LucasEmanuel313/Lucas-Emanuel-PCEIoT/Altium Project/Entregaveis 1/Lucas Emanuel - PCEIoT.xlsx

Line # | Name | Description | Designator | Quantity | Manufacturer 1 | Manufacturer Part Number 1 | Manufacturer Lifecycle 1 | Supplier 1 | Supplier Part Number 1 | Supplier Unit Price 1 | Supplier Subtotal 1
 | 19-217/R6C-AL1M2VY/3T | Chip LED, Red, 5 V, 25 mA, -40 to 85 degC, 2-Pin SMD (0603), RoHS, Tape and Reel | DS1 | 1 | Lumex | SML-LX0603IW-TR | Volume Production | Digikey | 67-1548-1-ND | 0.22 | 0.22
 | 22-28-4033 | KK 254 Breakaway Header Vertical 3 Circuits 0.38um Gold Selective Plating Mating Pin 6.09mm | P1 | 1 | Molex | 22-28-4033 | Volume Production | Digikey | WM50016-03-ND | 0.3 | 0.3
 | 640456-2 | Connector 250V AC/DC 5A 2P 1 Row PCB - Vertical Mounting Polyester White | J1 | 1 | TE Connectivity | 640456-2 | Volume Production | Digikey | A1921-ND | 0.15 | 0.15
 | 709670110 | Pcb Mounting, Nylon 6.6, 11Mm Rohs Compliant: Yes |Wurth Elektronik 709670110 | M1, M2, M7, M8 | 4 | Wurth Electronics | 709670110 | Unknown | Digikey | 732-10378-ND | 0.3 | 1.2
 | 970080354 | WA-SBRII Brass Spacer Stud Metric Thread int./int. | M3, M4, M9, M10 | 4 | Wurth Electronics | 970080354 | Unknown | Digikey | 732-12838-ND | 0.39 | 1.56
 | 5033981892 | Micro SD Card Connector, Pitch 1.1 mm, 8 Position, Height 1.4 mm, -25 to 85 degC, RoHS, Tape and Reel | SKT1 | 1 | Molex | 503398-1892 | Volume Production | Digikey | WM11190CT-ND | 2.62 | 2.62
 | 61300811821 | Btb Conn, Rcpt, 8Pos, 1Row, 2.54Mm Rohs Compliant: Yes |Wurth Elektronik 61300811821 | J6, J7, J8, J9 | 4 | Wurth Electronics | 61300811821 | Unknown | Digikey | 732-61300811821-ND | 0.38 | 1.52
 | 61302011821 | THT Vertical Socket Header WR-PHD, Pitch 2.54 mm, Single Row, 20 pins | J4, J5 | 2 | Wurth Electronics | 61302011821 | Unknown | Digikey | 732-61302011821-ND | 0.83 | 1.66
 | ASMT-YTB7-0AA02 | LED Tri-Color Blue/Green/Red 469nm/529nm/623nm Chip LED 6-Pin PLCC T/R | D1A, D1B, D1C | 3 | Broadcom Avago | ASMT-YTB7-0AA02 | Volume Production | Digikey | 516-3132-1-ND | 1.39 | 4.17
 | BLM21PG331SN1D | IND, Chip Ferrite Bead, 330 Ohm, +/- 25%, 1.5 A, -55 to 125 degC, 0805 (2012 Metric), Tape and Reel | L1, L2 | 2 | Murata | LQG15HS15NJ02D | Volume Production | Digikey | 490-2625-1-ND | 0.1 | 0.2
 | BQ29700DSER | Li-Ion/Li Polymer Advanced Single-Cell Battery Protector IC Family 6-WSON -40 to 85 | U9 | 1 | Texas Instruments | BQ29700DSER | Volume Production | Digikey | 296-43985-1-ND | 0.49 | 0.49
 | C0603C101K5GACTU | Multilayer Ceramic Capacitor, 100 pF, 50 V, ï¿½ 10%, C0G (NP0), 0603 [1608 Metric] | C7 | 1 | KEMET | C0603C101K5GACTU | Volume Production | Digikey | 399-C0603C101K5GACTUCT-ND | 0.1 | 0.1
 | Capacitor 4.7µF +/-20% 10V 0603 | Chip Capacitor, 4.7µF +/-20%, 10V, 0603, Thickness 1 mm | C19, C20 | 2 | Yageo | CC0603KRX5R6BB475 | Volume Production | Digikey | 311-1455-1-ND | 0.21 | 0.42
 | CMEJ-0415-42-LP | 4.0 mm, Omnidirectional, PCB Mount, 2.0 Vdc, Elecret Condenser Microphone | MK1 | 1 | Same Sky | CMEJ-0415-42-LP | Volume Production | Digikey | 102-6541-ND | 0.39 | 0.39
 | CRCW06032K20FKEA | SMD Chip Resistor, 2.2 kOhm, ± 1%, 100 mW, 0603 [1608 Metric], Thick Film, General Purpose | R19, R36 | 2 | Vishay | CRCW06032K20FKEA | Volume Production | Digikey | 541-2.20KHDKR-ND | 0.1 | 0.2
 | CRCW0603150RFKEA | SMD Chip Resistor, 150 Ohm, ± 1%, 100 mW, 0603 [1608 Metric], Thick Film, General Purpose | R32A, R32B, R32C | 3 | Vishay | CRCW0603150RFKEA | Volume Production | Digikey | 541-150HCT-ND | 0.1 | 0.3
 | CRCW0603470RJNEA | Res Thick Film 0603 470 Ohm 5% 0.1W(1/10W) ±200ppm/°C Pad SMD Automotive T/R | R37 | 1 | Vishay | CRCW0603470RJNEA | Volume Production | Digikey | 541-470GCT-ND | 0.1 | 0.1
 | ERJ-3EKF2001V | SMD Chip Resistor, 2 kOhm, ï¿½ 1%, 100 mW, 0603 [1608 Metric], Thick Film, Precision | R38 | 1 | Panasonic | ERJ-3EKF2001V | Volume Production | Digikey | P2.00KHCT-ND | 0.1 | 0.1
 | ERJ-3EKF3300V | SMD Chip Resistor, 330 Ohm, ± 1%, 100 mW, 0603 [1608 Metric], Thick Film, Precision | R35 | 1 | Panasonic | ERJ-3EKF3300V | Volume Production | Digikey | P330HCT-ND | 0.1 | 0.1
 | FSM4JSMA | Switch Tactile OFF (ON) SPST Round Button Gull Wing 0.05A 12VDC 1.57N SMD Loose Piece | SW1, SW2, SW3 | 3 | TE Connectivity | FSM4JSMA | Volume Production | Digikey | 450-1129-ND | 0.26 | 0.78
 | GRM188R60J106ME47D | Multilayer Ceramic Capacitor, 10 uF, 6.3 V, ± 20%, X5R, 0603 [1608 Metric] | C8 | 1 | Murata | GRM188R60J106ME47D | Volume Production | Digikey | 490-3896-6-ND | 0.11 | 0.11
 | LM4040DYM3-2.5-TR | LM4040 Series 2.5 V ±1 % Precision Micropower Shunt Voltage Reference - SOT-23 | U8 | 1 | Microchip | LM4040DYM3-2.5-TR | Volume Production | Digikey | 576-1047-1-ND | 0.36 | 0.36
 | MAX4466EXK-T | Audio Amp Microphone 1-CH Mono Class-AB 5-Pin SC-70 T/R | U4 | 1 | Maxim | MAX4466EXK-T | Volume Production | Digikey | MAX4466EXK+CT-ND | 1.62 | 1.62
 | MCP73831T-2ACI/OT | MCP73831 Series Single-Cell Li-Ion/Li-Polymer Battery Charge Controller SOT-23-5 | U10 | 1 | Microchip | MCP73831T-2ACI/OT | Volume Production | Digikey | MCP73831T-2ACI/OTDKR-ND | 0.76 | 0.76
 | MPMS 003 0005 PH | Mach Screw Pan Head Phillips M3 | M5, M6, M11, M12 | 4 | Building Fasteners | MPMS 003 0005 PH | Unknown | Digikey | H742-ND | 0.1156 | 11.56
 | MS563702BA03-50 | Pressure Sensor, Barometric, 300 mbar, 1200 mbar, QFN, 8, -40 C | U5 | 1 | TE Connectivity | MS563702BA03-50 | Volume Production | Digikey | 223-1199-1-ND | 3.69 | 3.69
 | NTRV4101PT1G | NTRV4101PT1G P-channel MOSFET Transistor; 1.7 A; 20 V; 3-Pin SOT-23 | Q1, Q2, Q3 | 3 | ON Semiconductor | NTRV4101PT1G | Volume Production | Digikey | 488-NTRV4101PT1GCT-ND | 0.67 | 2.01
 | Resistor 0R +/- 5% 0603 100 mW | Chip Resistor, 0 Ohm, 0.1 W, -55 to 155 degC, 0603 (1608 Metric) | R4, R7, R12, R30, R31 | 5 | Yageo | RC0603JR-070RL | Volume Production | Digikey | 311-0.0GRDKR-ND | 0.01 | 0.1
 | Resistor 1k +/-1% 0603 100 mW | Chip Resistor, 1 KOhm, +/-1%, 0.1 W, -55 to 155 degC, 0603 (1608 Metric) | R6, R11, R14, R17 | 4 | Yageo | RC0603FR-071KL | Volume Production | Digikey | 311-1.00KHRDKR-ND | 0.009 | 0.09
 | Resistor 10k +/-1% 0603 100 mW | Chip Resistor, 10 KOhm, +/- 1%, 01 W, -55 to 155 degC, 0603 (1608 Metric) | R1, R2, R3, R9, R10, R20, R21, R22, R23, R24, R25, R28, R29, R39, R40, R41, R42 | 17 | Yageo | RC0603FR-1310KL | Volume Production | Digikey | 13-RC0603FR-1310KLCT-ND | 0.009 | 0.153
 | Resistor 100k +/-1% 0603 100 mW | Chip Resistor, 100 KOhm, +/- 1%, 0.1 W, -55 to 155 degC, 0603 (1608 Metric) | R15, R16 | 2 | Yageo | RC0603FR-13100KL | Volume Production | Digikey | 13-RC0603FR-13100KLCT-ND | 0.009 | 0.09
 | SC0918 | Raspberry Pi Pico W RP2040 | U1 | 1 | Raspberry Pi | SC0918 | Volume Production | Digikey | 2648-SC0918CT-ND | 6 | 6
 | SHT40I-AD1B-R3 | Humidity And Temperature Sensor | U6 | 1 | Sensirion | SHT40I-AD1B-R3 | Unknown | Digikey | 1649-SHT40I-AD1B-R3CT-ND | 2.21 | 2.21
 | SX1509BIULTRT | IC Gpio Expander I2C 16CH 28QFN / I2C Interface 5.5V 28-PIN Qfn-ut Ep T/r | U7 | 1 | Semtech | SX1509BIULTRT | Volume Production | Digikey | SX1509BIULCT-ND | 4.79 | 4.79
 | TC33X-2-104E | Cermet trimmer potentiometer, 100 kΩ, 0.1 W, SMD, on top, TC33X-2-104E | R18 | 1 | Bourns | TC33X-2-104E | Volume Production | Digikey | TC33X-104ECT-ND | 0.25 | 0.25
 | VJ0603Y103KXAAC | Multilayer Ceramic Capacitor, 0.01 uF, 50 V, ± 10%, X7R, 0603 [1608 Metric] | C15, C16, C17, C27 | 4 | Vishay Vitramon | VJ0603Y103KXAAC | Volume Production | Digikey | 720-1376-1-ND | 0.19 | 0.76
 | VJ0603Y104MXJCW1BC | Multilayer Ceramic Capacitor, 0.1 uF, 16 V, ± 20%, X7R, 0603 [1608 Metric] | C1, C2, C3, C4, C5, C6, C9, C10, C11, C12, C13, C14, C18, C21, C22, C23, C24, C25, C26, C28, C29 | 21 | Vishay Vitramon | VJ0603Y104MXJCW1BC | Volume Production | Digikey | 720-VJ0603Y104MXJCW1BCCT-ND | 0.058 | 1.22
 | ICM-42670-P | Mems Module, 1.71-3.6 V, Lga-14 Rohs Compliant: Yes |Tdk Invensense ICM-42670-P | U2 | 1 | TDK InvenSense | ICM-42670-P | Manual Solution | DigiKey | 1428-ICM-42670-PTR-ND | 3.66 | 3.66
 | CRCW060350R0FKEA | SMD Chip Resistor, 50 Ohm, ± 1%, 100 mW, 0603 [1608 Metric], Thick Film, General Purpose | R33A, R33B, R33C, R34A, R34B, R34C | 6 | Vishay Dale | CRCW060350R0FKEA | Volume Production | Mouser | 71-CRCW0603-50-E3 | 0.033 | 0.33
 | OPT4001DTSR | High-speed high-precision digital ambient light sensor (ALS) 8-SOT-5X3 -40 to 85 | U3 | 1 | Texas Instruments | OPT4001DTSR | Volume Production | Mouser | 595-OPT4001DTSR | 2.17 | 2.17
