LucasEmanuel313/Lucas-Emanuel-PCEIoT/(list of files, drawings)

Other design files:
Altium Project/Lucas Emanuel - PCEIoT/Lucas Emanuel - PCEIoT.PrjPcb
Altium Project/Lucas Emanuel - PCEIoT/PCB1.PcbDoc
Altium Project/Lucas Emanuel - PCEIoT/Sources/[1] TableOfContents.SchDoc
Altium Project/Lucas Emanuel - PCEIoT/Sources/[2] BlockDiagram.SchDoc
Altium Project/Lucas Emanuel - PCEIoT/Sources/[3] TopLevel.SchDoc
Altium Project/Lucas Emanuel - PCEIoT/Sources/[4] Sensors.SchDoc
Altium Project/Lucas Emanuel - PCEIoT/Sources/[5] ButtonsAndLeds.SchDoc
Altium Project/Lucas Emanuel - PCEIoT/Sources/[6] RgbLed.SchDoc
Altium Project/Lucas Emanuel - PCEIoT/Sources/[7] PowerManagement.SchDoc
Altium Project/Lucas Emanuel - PCEIoT/Sources/[8] Conectors.SchDoc
Altium Project/Lucas Emanuel - PCEIoT/Sources/[9] Mechanical.SchDoc
