LucasEmanuel313/Lucas-Emanuel-PCEIoT/(commit log)

2025-02-17 [Sheets] Primeiro commit, criação de sheets e estrutura geral do projeto
    [Lucas Emanuel - PCEIoT.PrjPcb, [1] TableOfContents.SchDoc, [2] BlockDiagram.SchDoc, [3] TopLevel.SchDoc, [4] Sensors.SchDoc, [5] ButtonsAndLeds.SchDoc, [6] RgbLed.SchDoc, [7] PowerManagement.SchDoc]
2025-02-17 [Sheets] Finalização das sheets table of Contents e BlockDiagram. Atualização do TopLevel.
    [Lucas Emanuel - PCEIoT.PrjPcb, [1] TableOfContents.SchDoc, [2] BlockDiagram.SchDoc, [3] TopLevel.SchDoc]
2025-02-18 [Sheets] Progresso na sheet de sensores
    [Lucas Emanuel - PCEIoT.PrjPcb, [1] TableOfContents.SchDoc, [2] BlockDiagram.SchDoc, [3] TopLevel.SchDoc, [4] Sensors.SchDoc]
2025-02-18 [Sheets] Atualização nas páginas de LED e Expansor de GPIO
    [Lucas Emanuel - PCEIoT.PrjPcb, PCB1.PcbDoc, [4] Sensors.SchDoc, [5] ButtonsAndLeds.SchDoc, [6] RgbLed.SchDoc]
2025-02-20 [Sheets] Atualização da Sheet Connectors, correção de esquemático na Sheet de Buttons and LEDs e sincronização do top Level.
    [Lucas Emanuel - PCEIoT.PrjPcb, [3] TopLevel.SchDoc, [5] ButtonsAndLeds.SchDoc, [8] Conectors.SchDoc]
2025-02-20 [Sheets] Criação das demais sheets
    [Lucas Emanuel - PCEIoT.PrjPcb, [3] TopLevel.SchDoc, [7] PowerManagement.SchDoc, [9] Mechanical.SchDoc]
2025-02-24 [Sheets] Finalização do esquemático e correção de erros
    [Lucas Emanuel - PCEIoT.PrjPcb, [3] TopLevel.SchDoc, [4] Sensors.SchDoc, [5] ButtonsAndLeds.SchDoc, [6] RgbLed.SchDoc, [7] PowerManagement.SchDoc, [8] Conectors.SchDoc]
2025-03-23 Alteração da biblioteca dos componentes e exportação de entregáveis
    [Lucas Emanuel - PCEIoT.PrjPcb, Lucas Emanuel - PCEIoT.xlsx, [1] TableOfContents.SchDoc, [3] TopLevel.SchDoc, [4] Sensors.SchDoc, [5] ButtonsAndLeds.SchDoc, [6] RgbLed.SchDoc, [7] PowerManagement.SchDoc]
2025-04-14 [PCB] Agrupamento de componentes
    [Lucas Emanuel - PCEIoT.PrjPcb]
2025-04-22 [PCB] Agrupamento do circuito da bateria e posicionamento dos componentes principais
    [Lucas Emanuel - PCEIoT.PrjPcb, [3] TopLevel.SchDoc, [4] Sensors.SchDoc, [5] ButtonsAndLeds.SchDoc, [7] PowerManagement.SchDoc, [8] Conectors.SchDoc]
2025-04-23 [PCB] Adição de elementos gráficos e avanços na disposição dos componentes
2025-04-24 [PCB] Roteamento Bateria, GPIO e Sensores
    [[5] ButtonsAndLeds.SchDoc]
2025-05-12 [PCB] MikroBus e TestPoints
    [Lucas Emanuel - PCEIoT.PrjPcb, [3] TopLevel.SchDoc, [4] Sensors.SchDoc, [6] RgbLed.SchDoc]
